Alber97/robotyka2/Projekt EAGLE/board.brd

## EAGLE design Projekt EAGLE/board.brd (2021-02-22)

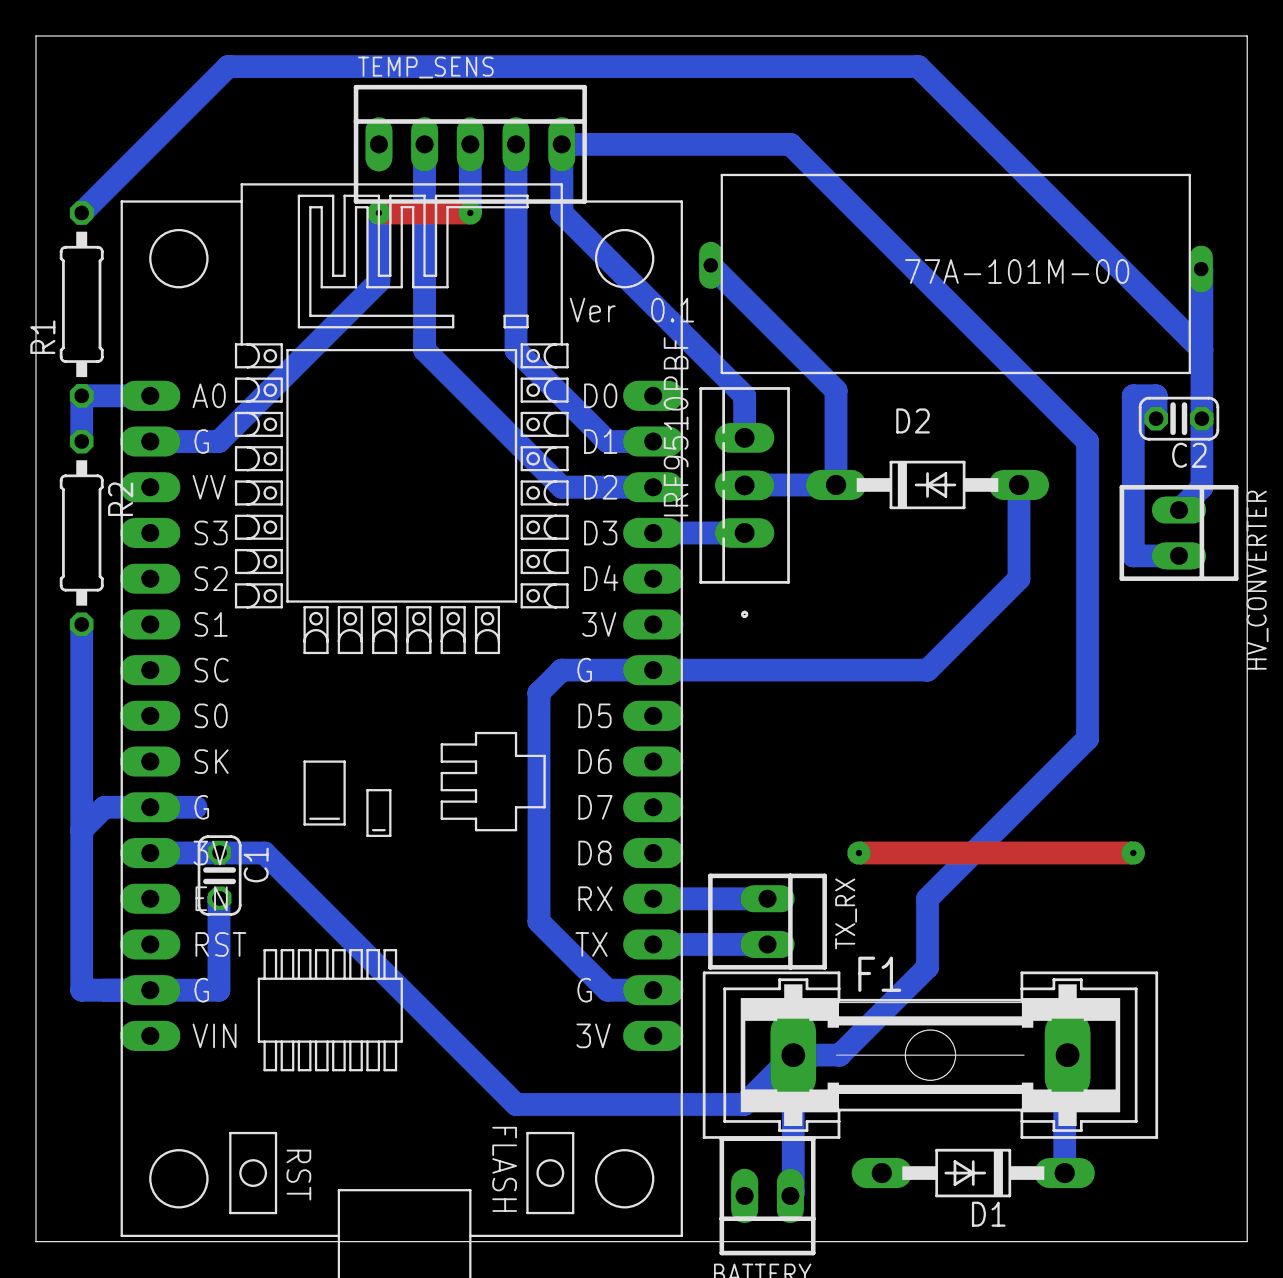
[picture p18: board board.brd from above]

Board: 2 copper layers, 67.3 x 67.0 mm, 14 parts (0 on the bottom side), 12 nets.

Parts:
BATTERY: 22-23-2021
C1, C2: C025-024X044
D1, D2: 1N4004LONGFOOTPRINT; LONGFOOTPRINT
F1: GSH15
HV_CONVERTER: 22-23-2021
R1, R2: 0207/10
TEMP_SENS: 22-23-2051
TX_RX: 22-23-2021
U1: IRF9510PBFIRF95110PBF; IRF9510PBF
U$1: NODEMCU
U$2: 77A-101M-00

Connections:
3V: U$1.16, U$1.25
GND: BATTERY.2, C1.2, C2.2, D1.A, D2.A, HV_CONVERTER.2, R2.2, TEMP_SENS.3, U$1.2, U$1.10, U$1.14, U$1.17, U$1.24
unnamed: D1.C, F1.2
unnamed: D2.C, U1.2, U$2.1
unnamed: TX_RX.1, U$1.19
unnamed: TX_RX.2, U$1.18
unnamed: R1.1, R2.1, U$1.1
PWM: U1.1, U$1.27
REG_OUT: C2.1, HV_CONVERTER.1, R1.2, U$2.2
SCLK: TEMP_SENS.4, U$1.29
SDA: TEMP_SENS.2, U$1.28
V_BATT: BATTERY.1, C1.1, F1.1, TEMP_SENS.5, U1.3, U$1.11
