Alber97/robotyka2/(commit log)

2021-02-22 Dodanie danych pomiarowych
    [Uwe_1.7V.CSV, Uwe_2.1V.CSV, Uwe_2.4V.CSV, Uwe_2.8V.CSV, Uwe_3.3V.CSV, Uwe_3.7V.CSV]
2021-02-22 Dodanie projektu EAGLE
    [board.brd, board.sch]
